deanasmith/vision-arm/pcb/pcb.kicad_pcb

## KiCad design pcb/pcb.kicad_pcb (2026-10-12)

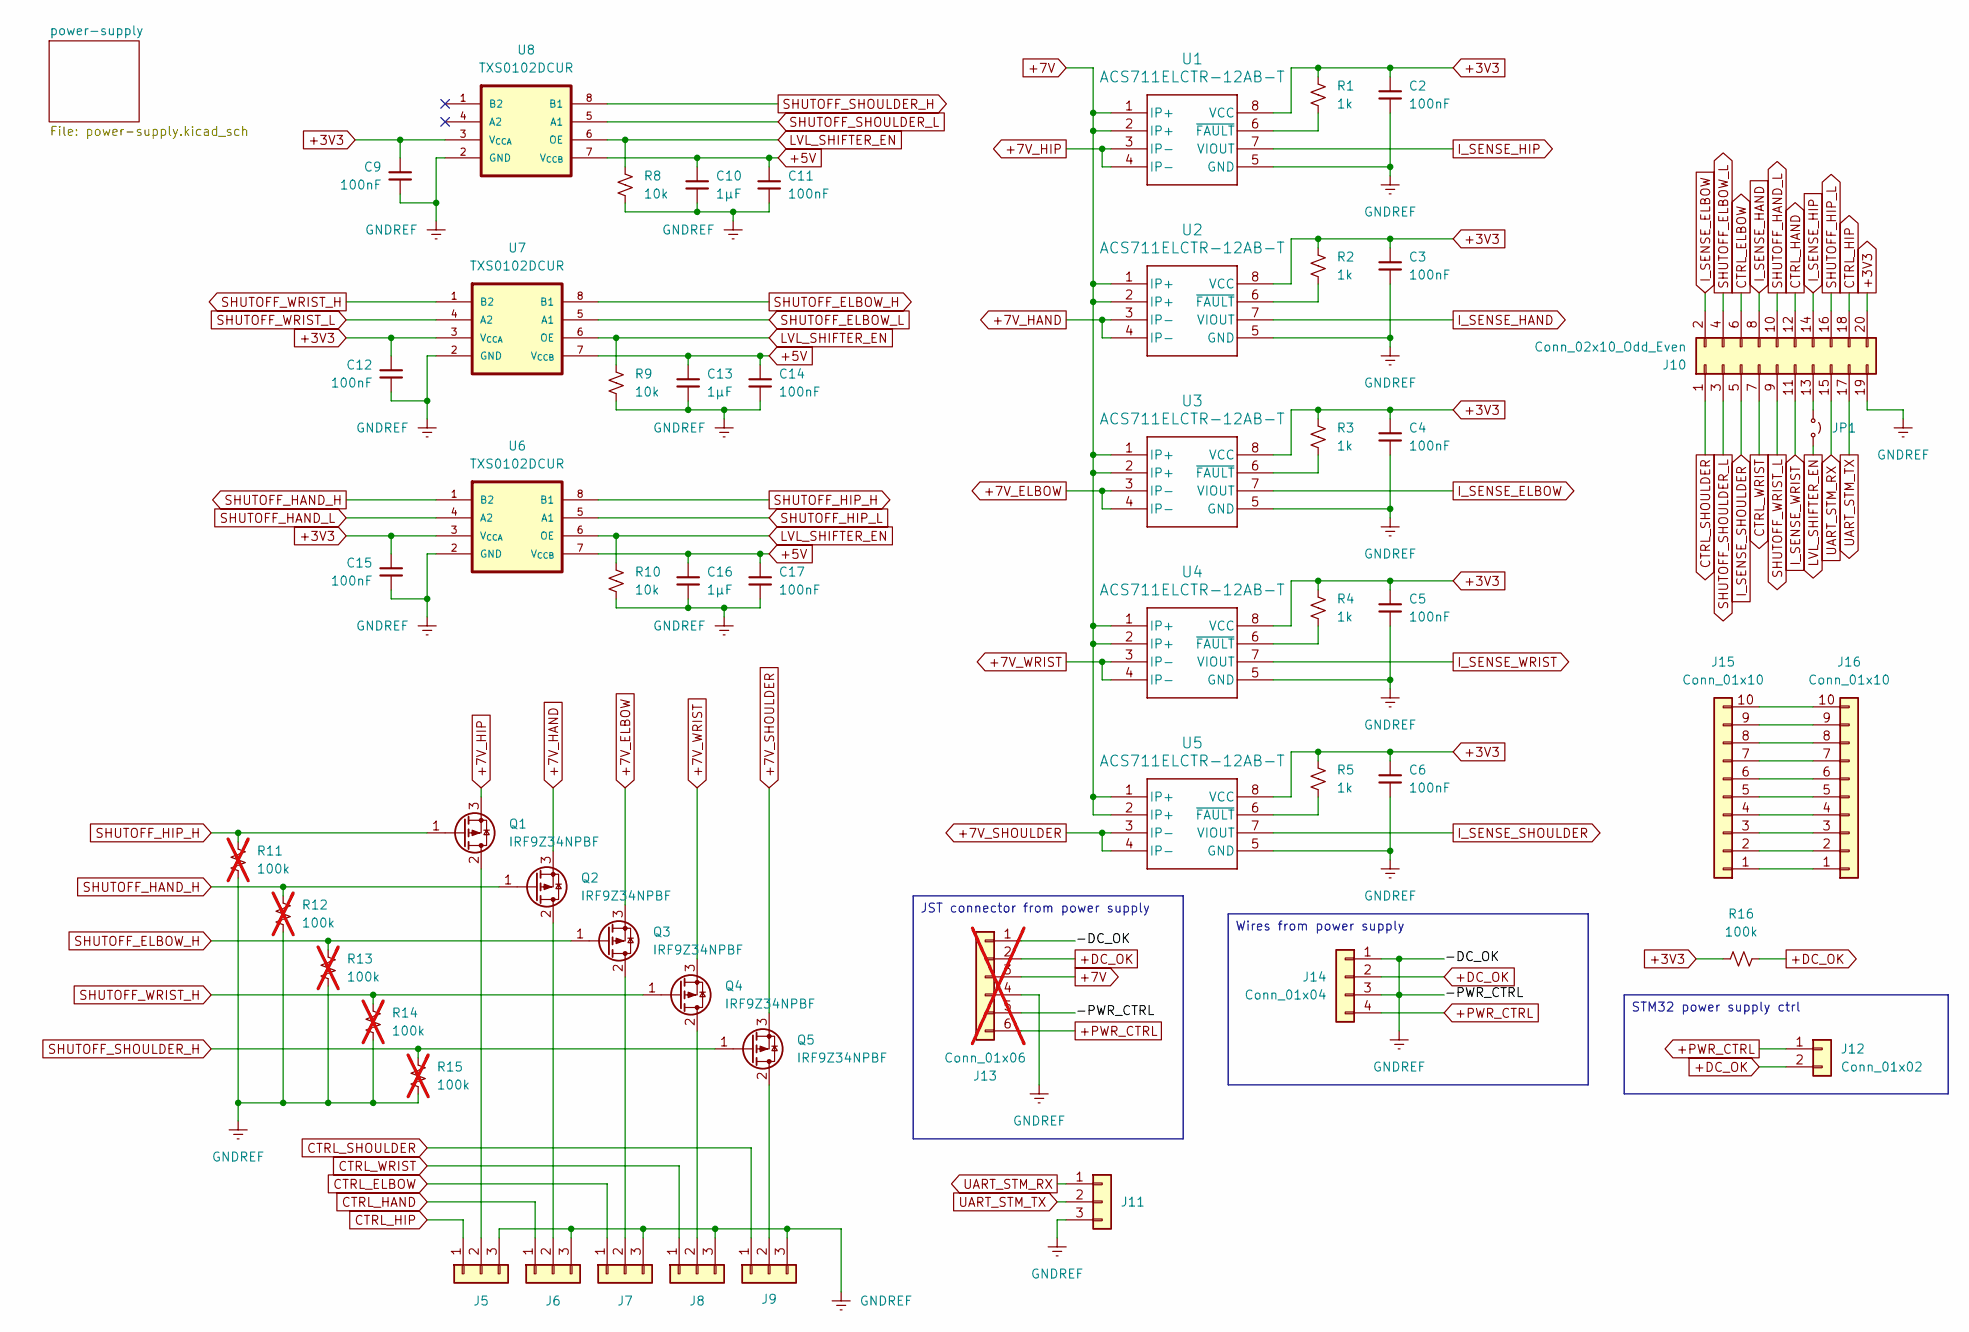
[picture p1: schematic pcb.kicad_sch]

Parts:
C2, C3, C4, C5, C6, C9, C11, C12, C14, C15, C17: 100nF; C_0805_2012Metric_Pad1.18x1.45mm_HandSolder
C10, C13, C16: 1µF; C_0805_2012Metric_Pad1.18x1.45mm_HandSolder
J5, J6, J7, J8, J9, J11: Conn_01x03; PinHeader_1x03_P2.54mm_Vertical
J10: Conn_02x10_Odd_Even; PinHeader_2x10_P2.54mm_Vertical
J12: Conn_01x02; PinHeader_1x02_P2.54mm_Vertical
J13: Conn_01x06; LTC-4627Jx; not fitted
J14: Conn_01x04; PinHeader_1x04_P2.54mm_Vertical
J15, J16: Conn_01x10; PinHeader_1x10_P2.54mm_Vertical
JP1: Jumper_2_Small_Open; PinHeader_1x02_P2.54mm_Vertical
Q1, Q2, Q3, Q4, Q5: IRF9Z34NPBF; TO-220-3_Vertical; DigiKey Part Number IRF9Z34NPBF-ND
R1, R2, R3, R4, R5: 1k; R_0805_2012Metric_Pad1.20x1.40mm_HandSolder
R8, R9, R10: 10k; R_0805_2012Metric_Pad1.20x1.40mm_HandSolder
R11, R12, R13, R14, R15: 100k; R_0805_2012Metric_Pad1.20x1.40mm_HandSolder; not fitted
R16: 100k; R_0805_2012Metric_Pad1.20x1.40mm_HandSolder
U1, U2, U3, U4, U5: ACS711ELCTR-12AB-T; SOICN-8_ALM; DigiKey Part Number 620-1370-1-ND
U6, U7, U8: TXS0102DCUR; SOP50P310X90-8N; DigiKey Part Number 296-21931-1-ND

Connections:
+3V3: C2.1, C3.1, C4.1, C5.1, C6.1, C9.1, C12.1, C15.1, J10.20, R1.1, R2.1, R3.1, R4.1, R5.1, R16.2, U1.8 (VCC), U2.8 (VCC), U3.8 (VCC), U4.8 (VCC), U5.8 (VCC), U6.3 (V_{CCA}), U7.3 (V_{CCA}), U8.3 (V_{CCA}); also elsewhere on the board
+5V: C10.1, C11.1, C13.1, C14.1, C16.1, C17.1, U6.7 (V_{CCB}), U7.7 (V_{CCB}), U8.7 (V_{CCB}); also elsewhere on the board
+7V: J13.3, U1.1 (IP+), U1.2 (IP+), U2.1 (IP+), U2.2 (IP+), U3.1 (IP+), U3.2 (IP+), U4.1 (IP+), U4.2 (IP+), U5.1 (IP+), U5.2 (IP+); also elsewhere on the board
+7V_ELBOW: Q3.3 (S), U3.3 (IP-), U3.4 (IP-)
+7V_HAND: Q2.3 (S), U2.3 (IP-), U2.4 (IP-)
+7V_HIP: Q1.3 (S), U1.3 (IP-), U1.4 (IP-)
+7V_SHOULDER: Q5.3 (S), U5.3 (IP-), U5.4 (IP-)
+7V_WRIST: Q4.3 (S), U4.3 (IP-), U4.4 (IP-)
+DC_OK: J12.2, J13.2, J14.2, R16.1
+PWR_CTRL: J12.1, J13.6, J14.4
CTRL_ELBOW: J7.1, J10.6
CTRL_HAND: J6.1, J10.12
CTRL_HIP: J5.1, J10.18
CTRL_SHOULDER: J9.1, J10.1
CTRL_WRIST: J8.1, J10.7
GNDREF: C2.2, C3.2, C4.2, C5.2, C6.2, C9.2, C10.2, C11.2, C12.2, C13.2, C14.2, C15.2, C16.2, C17.2, J5.3, J6.3, J7.3, J8.3, J9.3, J10.19, J11.3, J13.1, J13.4, J13.5, J14.1, J14.3, R8.2, R9.2, R10.2, R11.2, R12.2, R13.2, R14.2, R15.2, U1.5 (GND), U2.5 (GND), U3.5 (GND), U4.5 (GND), U5.5 (GND), U6.2 (GND), U7.2 (GND), U8.2 (GND); also elsewhere on the board
I_SENSE_ELBOW: J10.2, U3.7 (VIOUT)
I_SENSE_HAND: J10.8, U2.7 (VIOUT)
I_SENSE_HIP: J10.14, U1.7 (VIOUT)
I_SENSE_SHOULDER: J10.5, U5.7 (VIOUT)
I_SENSE_WRIST: J10.11, U4.7 (VIOUT)
LVL_SHIFTER_EN: JP1.2 (B), R8.1, R9.1, R10.1, U6.6 (OE), U7.6 (OE), U8.6 (OE)
unnamed: J5.2, Q1.2 (D)
unnamed: J6.2, Q2.2 (D)
unnamed: J7.2, Q3.2 (D)
unnamed: J8.2, Q4.2 (D)
unnamed: J9.2, Q5.2 (D)
unnamed: J10.13, JP1.1 (A)
unnamed: J15.1, J16.1
unnamed: J15.2, J16.2
unnamed: J15.3, J16.3
unnamed: J15.4, J16.4
unnamed: J15.5, J16.5
unnamed: J15.6, J16.6
unnamed: J15.7, J16.7
unnamed: J15.8, J16.8
unnamed: J15.9, J16.9
unnamed: J15.10, J16.10
unnamed: R1.2, U1.6 (~FAULT)
unnamed: R2.2, U2.6 (~FAULT)
unnamed: R3.2, U3.6 (~FAULT)
unnamed: R4.2, U4.6 (~FAULT)
unnamed: R5.2, U5.6 (~FAULT)
SHUTOFF_ELBOW_H: Q3.1 (G), R13.1, U7.8 (B1)
SHUTOFF_ELBOW_L: J10.4, U7.5 (A1)
SHUTOFF_HAND_H: Q2.1 (G), R12.1, U6.1 (B2)
SHUTOFF_HAND_L: J10.10, U6.4 (A2)
SHUTOFF_HIP_H: Q1.1 (G), R11.1, U6.8 (B1)
SHUTOFF_HIP_L: J10.16, U6.5 (A1)
SHUTOFF_SHOULDER_H: Q5.1 (G), R15.1, U8.8 (B1)
SHUTOFF_SHOULDER_L: J10.3, U8.5 (A1)
SHUTOFF_WRIST_H: Q4.1 (G), R14.1, U7.1 (B2)
SHUTOFF_WRIST_L: J10.9, U7.4 (A2)
UART_STM_RX: J10.15, J11.1
UART_STM_TX: J10.17, J11.2

Notes on the sheet:
JST connector from power supply
Wires from power supply
STM32 power supply ctrl

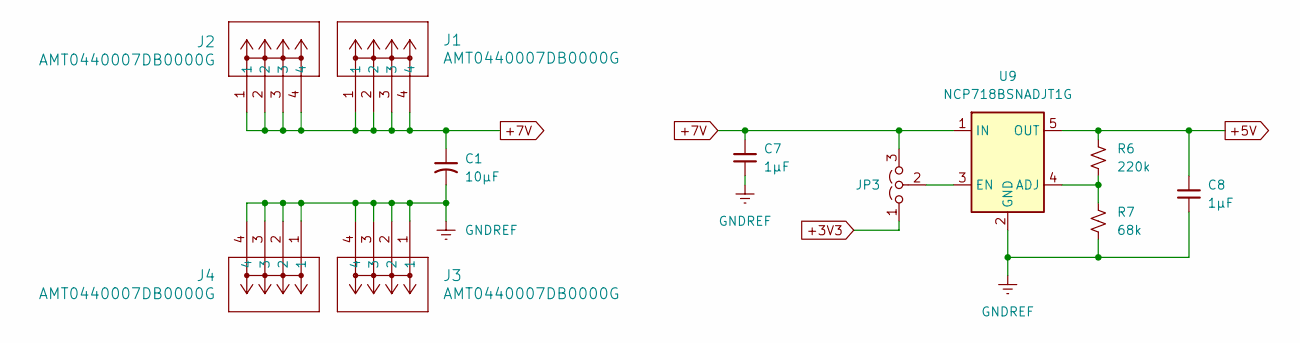
[picture p2: schematic power-supply.kicad_sch, 7V and 5V Power Supplies]

Parts:
C1: 10µF; C_Radial_D6.3mm_H11.0mm_P2.50mm
C7, C8: 1µF; C_0805_2012Metric_Pad1.18x1.45mm_HandSolder
J1, J2, J3, J4: AMT0440007DB0000G; CONN_AMT0440007DB0000G_AMP; Mouser Part Number 523-AMT0680001DB000G; DigiKey Part Number 1818-AMT0440007DB0000G-ND
JP3: Jumper_3_Open; PinHeader_1x03_P2.54mm_Vertical
R6: 220k; R_0805_2012Metric_Pad1.20x1.40mm_HandSolder
R7: 68k; R_0805_2012Metric_Pad1.20x1.40mm_HandSolder
U9: NCP718BSNADJT1G; TSOT-23-5_HandSoldering; DigiKey Part Number NCP718BSNADJT1GOSCT-ND

Connections:
+3V3: JP3.1 (A); also elsewhere on the board
+5V: C8.1, R6.1, U9.5 (OUT); also elsewhere on the board
+7V: C1.1, C7.1, J1.1, J1.2, J1.3, J1.4, J2.1, J2.2, J2.3, J2.4, JP3.3 (B), U9.1 (IN); also elsewhere on the board
GNDREF: C1.2, C7.2, C8.2, J3.1, J3.2, J3.3, J3.4, J4.1, J4.2, J4.3, J4.4, R7.2, U9.2 (GND); also elsewhere on the board
unnamed: JP3.2 (C), U9.3 (EN)
unnamed: R6.2, R7.1, U9.4 (ADJ)

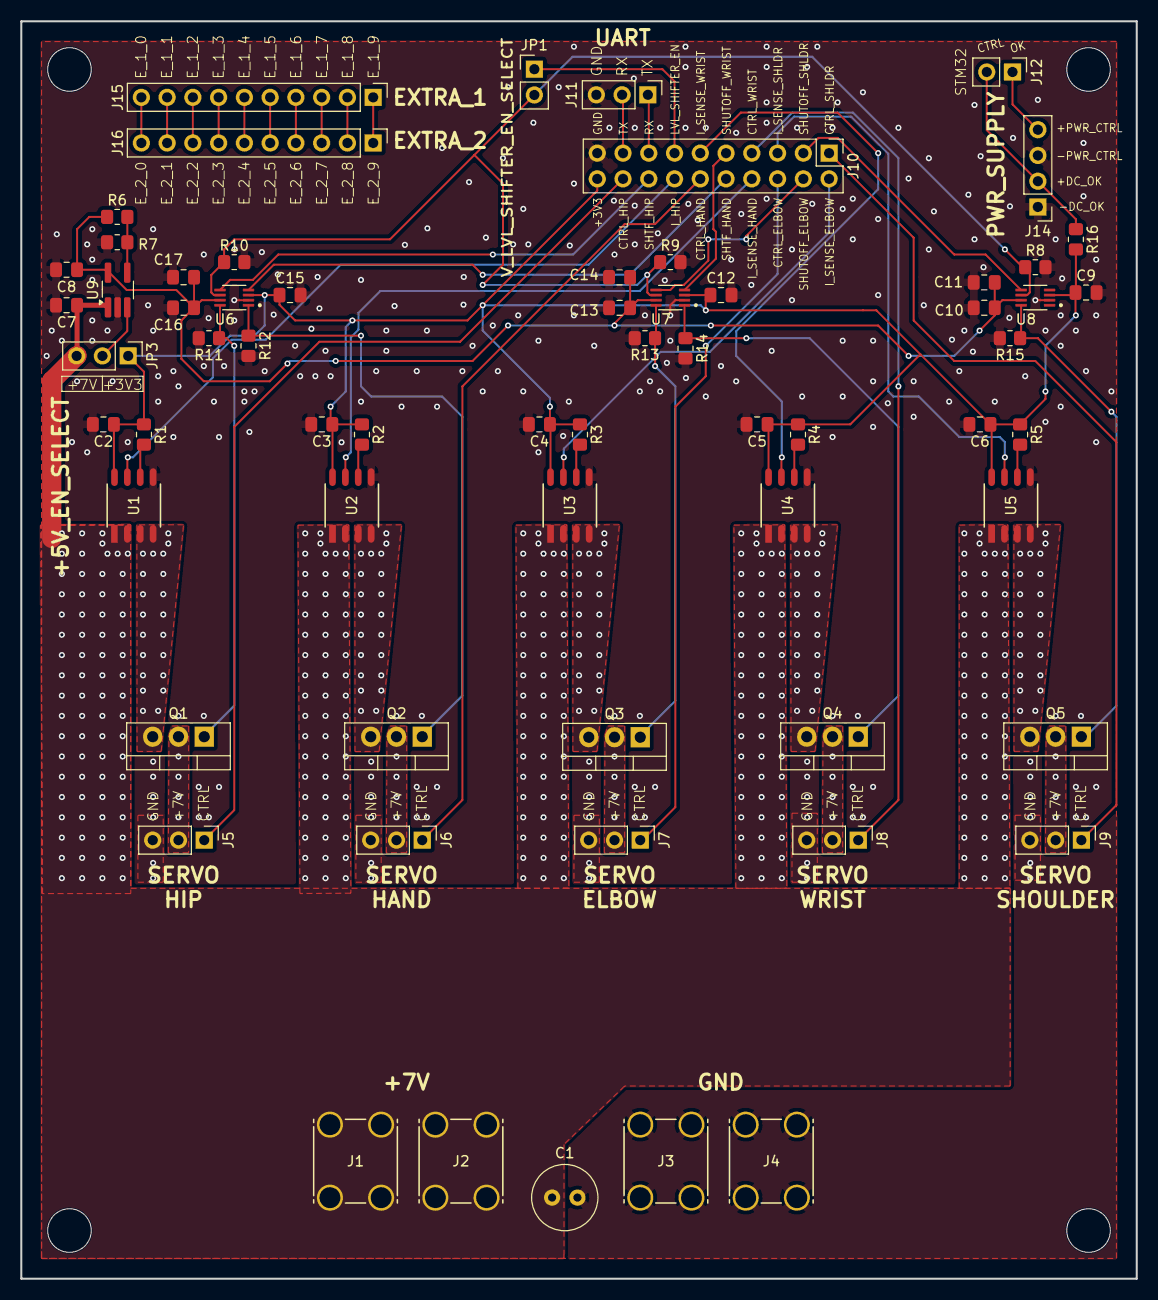
[picture p3: board pcb.kicad_pcb from above]

Board: 2 copper layers, 110.0 x 124.0 mm, 64 parts (0 on the bottom side), 57 nets.
