deanasmith/vision-arm/(commit log)

2026-09-08 Add .gitattributes for Python, KiCad, and others
    * Add .gitattributes for Python, KiCad, and others
    The `.gitattributes` file helps ensure the line endings in different
    file types don't get changed when commits are made on different OSs.
    Without `.gitattributes`, Git doesn't always enforce checking in files
    with consistent endings. Most text editors can read both CRLF and LF
    line endings, but binary files and scripts should never be changed.
    * Change KiCad files to binary
    Git kept complaining that there were CRLF line endings that would get
    converted even though the files are represented as text. Keeping them as
    binary with CRLF works fine for now.
2026-09-08 Add initial KiCad project
    [pcb.kicad_pcb, pcb.kicad_sch]
2026-09-08 Add KiCad files to .gitignore
2026-09-08 Add screw terminal symbol, footprint, and 3D model
    The power supply will connect to the board via these screw terminals.
    These screw terminals were the cheapest ones on DigiKey, and they give
    us plenty of current headroom for the servos.
2026-09-08 Add screw terminals and headers to schematic
    The chosen power supply has two +V and -V output pairs, so we have two
    screw terminals in parallel with the assumption that they have the same
    voltage at all times. I put a 10uF cap between them to smooth out the DC
    voltage and hopefully prevent transient spikes from the servos. I chose
    10uF arbitrarily.
    Each servo has its own 3-pin Dupont-style header to connect to for power
    and control. This lets us place them anywhere on the board to make
    hookup more convenient instead of a single long header.
    The servo control signals from the microcontroller are routed to a
    separate header. That header has extra pins routed to another empty
    header in case w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
    [pcb.kicad_sch]
2026-09-20 Replace screw terminals with M4 screw connectors
    We want to use the same ring connectors for both the power supply and
    the PCB to reduce the number of components. The power supply we're using
    has M3.5 screw connectors for its output. There weren't any M3.5 screw
    connectors available for the PCB, so M4 was the next closest. We're
    going to try using M4 connectors for both the PCB and the power supply
    instead of the previous M8 screw connectors.
    [pcb.kicad_sch]
2026-09-20 Add Hall effect sensors to schematic
    [pcb.kicad_sch]
2026-09-20 Add PMOSFET symbol for servo overcurrent shutoff
2026-09-20 Add overcurrent shutoff MOSFETs to schematic
    [pcb.kicad_sch]
2026-09-20 Add passive comps and labels for HE sensors and level shifters
    [pcb.kicad_sch]
2026-09-21 Add 5V LDO regulator symbol
2026-09-21 Add 5V LDO regulator to schematic
    [pcb.kicad_sch]
2026-09-21 Move power supply circuit to hierarchial sheet
    [pcb.kicad_sch, power-supply.kicad_sch]
2026-09-21 Add passives for level shifters and enable jumper
    [pcb.kicad_sch]
2026-09-21 Rotate PMOSFET array for readability
    [pcb.kicad_sch]
2026-09-21 Add header labels for UART and 3.3V
    [pcb.kicad_sch, power-supply.kicad_sch]
2026-09-21 Add jumper to choose 3.3V or 7V for regulator enable
    I'm not sure if using the 7V input voltage is alright, or if 7V is too
    high. The datasheet for the LDO regulator `NCP718BSNADJT1G` doesn't seem
    to make it clear, so the jumper lets us keep this same PCB design
    without ordering a new board.
    [power-supply.kicad_sch]
2026-09-21 Add extra header for future STM32 GPIO use
    [pcb.kicad_sch]
2026-09-21 Change screw terminal to cheaper model
    [power-supply.kicad_sch]
2026-09-21 Fix ERC errors
    [pcb.kicad_sch, power-supply.kicad_sch]
2026-09-25 Move symbols and footprints to single common lib
    Having a unique library for each component makes the components
    difficult to search. Moving them under a single library, `lib`, makes
    them easier to find.
    [pcb.kicad_sch, power-supply.kicad_sch]
2026-09-25 Assign footprints for components
    [pcb.kicad_sch, power-supply.kicad_sch]
2026-09-26 Add power supply remote control header and labels
    [pcb.kicad_sch, power-supply.kicad_sch]
2026-09-26 Fix wrong footprint on J5-J9 and J11
    [pcb.kicad_sch]
2026-09-26 Add general PCB layout
    [pcb.kicad_pcb]
2026-09-26 Change C1 to be THT electrolytic instead of SMT
    C1 is the largest filtering capacitor, which is used for the power
    supply. It was previously an 0805 surface mount footprint. Changing it
    to a through hole footprint gives us more flexibility if we need a
    diferent capacitance.
    [pcb.kicad_pcb, power-supply.kicad_sch]
2026-09-26 Add general 5V regulator layout
    [pcb.kicad_pcb]
2026-09-26 Add general Hall effect sensor layout
    [pcb.kicad_pcb]
2026-09-26 Add general level shifter layout
    [pcb.kicad_pcb]
2026-09-26 Swap servo label order for better layout
    The schematic labels for the servo control and voltage signal nets were
    previously assigned randomly. This commit reorders the labels so the two
    larger servos are along the edge of the board for less interference on
    adjacent Hall effect sensors. This commit also changes the labels so the
    high side signals of each IC controls two MOSFETs that are close to each
    other.
    [pcb.kicad_pcb, pcb.kicad_sch]
2026-09-26 Move +7V terminals and servo power components
    The previous layout of the +7V screw terminals, PMOSFETS, servo headers,
    and +5V power supply didn't take into account how the Hall effect sensor
    power planes were going to be routed. This commit moves these components
    and subcircuits to make the power planes easier to route.
    [pcb.kicad_pcb]
2026-09-26 Add bypass capacitors for each level shifter
    The datasheet for the level shifter recommends placing the bypass
    capacitors as close as possible to the IC. Ideally, we could probably
    get away with just the one set. However, since the level shifters are
    placed so far away from each other, it's probably better to have more
    caps and slightly higher capacicance.
    [pcb.kicad_pcb, pcb.kicad_sch]
2026-09-26 Change 2x10 headers to use odd-even symbol
    The default footprint uses the odd-even pinout, but the schematic was
    drawn with a counter clockwise pinout. The pin numbers in the schematic
    are arbitrary, so changing the symbol was easier than changing the
    footprint pinout to match the counter clockwise symbol.
    [pcb.kicad_pcb, pcb.kicad_sch]
2026-09-26 Add missing power supply ctrl header and move STM32 header labels
    The header for connecting the power supply control wires to the PCB was
    missing from the schematic. This commit adds that header and makes the
    schematic more clear with respect to the JST connector signals, the
    signals associated with the wires from the JST connector, and the
    signals that are routed to the STM32.
    This commit also rearranges the STM32 header labels to be easier to
    route.
    [pcb.kicad_pcb, pcb.kicad_sch]
2026-09-26 Move +5V regulator to low power side of PCB
    The +5V regulator was a bit cramped on the high-power side of the board
    with the +7V and ground planes. Moving it to the low side gives those
    planes more room and brings the +5V source closer to where it's used.
    [pcb.kicad_pcb]
2026-10-03 Add layout for +7V components
    [pcb.kicad_pcb, pcb.kicad_sch]
2026-10-03 Add some easy traces
    [pcb.kicad_pcb]
2026-10-04 Add traces for PMOSFET shutdown and ctrl signals
    [pcb.kicad_pcb]
2026-10-04 Add traces for Hall effect ICs and +3.3V supply
    [pcb.kicad_pcb]
2026-10-04 Add +5V supply traces and stitching vias
    [pcb.kicad_pcb]
2026-10-06 Fix STM32 header footprint and add silkscreen
    [pcb.kicad_pcb, pcb.kicad_sch]
2026-10-11 Add silkscreen info about PCB and tidy silkscreen
2026-10-12 Add PCB mounting holes
2026-10-12 Fix vias with no net and hole in ground plane
